kegedy/Arduino-Uno-Rev3-Remodeled/Project Outputs for 28Pins_Project/BOM/BOM Grouped Reference - 28Pins V1I1 - FIXED 5V and 3V3.xlsx

Designator | Quantity | Comment | Description | Case/Package | Manufacturer | Manufacturer Part Number | Supplier 1 | Supplier Part Number 1
C1, C2, C5, C12, C25, C26, C28, C29 | 8 | 10uF / 16V | CERAMIC CAPACITOR, 10UF, 16V, X5R, 20%, 0805, FULL REEL; Product Range:C Series; Capacitance:10 F; Capacitance Tolerance: 20%; Dielectric Characteristic:X5R; Voltage Rating:16V; Ceramic Capacitor Case:0805 [2012 Metric]; MSL:- ;RoHS Compliant: Yes | 0805 | TDK | C2012X5R1C106M125AC | Farnell | 2525134
C3, C4, C6, C7, C8, C9, C10, C11, C13, C14, C15, C18, C20, C21, C24, C27, C30, C31 | 18 | 100nF | C Series 0805 0.1 uF 50 V ±10 % Tolerance X7R SMT Multilayer Ceramic Capacitor | 0805 | TDK | C2012X7R1H104K085AA | Digi-Key | 445-7534-1-ND
C16, C17 | 2 | 100uF / 10V | CAP ALUM 100UF 20% 10V SMD | Radial | Panasonic | EEE-1AA101WR | Digi-Key | PCE3867DKR-ND
C19 | 1 | 1uF / 25V | CAP CER 1UF 25V X5R 0805 | 0805 | TDK | C2012X5R1E105K125AA | Digi-Key | 445-1419-1-ND
C22, C23, C32, C33 | 4 | 18pf | Cap Ceramic 18pF 50V C0G 5% SMD 0805 125C Paper T/R | 0805 | KEMET | C0805C180J5GACTU | Digi-Key | 399-C0805C180J5GAC7800CT-ND
D1, D3 | 2 | BAT54HT1G | VR=30V IF=200mA 10pF P=200mW |  | ON Semiconductor / Fairchild | BAT54HT1G | Digi-Key | BAT54HT1GOSCT-ND
D2 | 1 | Green | LED Uni-Color True Green 525nm 2-Pin Chip 0603(1608Metric) T/R | 0603 | Osram Opto | LT Q39G-Q1OO-25-1 | Mouser | 720-LTQ39GQ1S22515
D4, D5, D6 | 3 | Orange | LED Uni-Color Orange 610nm 2-Pin Case 0603 T/R | 1608 | Osram Opto | LOL29K-H2K1-24 | Mouser | 720-LOL29KH2K124Z
FB1, FB2, FB3 | 3 | MPZ2012S601AT000 | 0805 600Ω ±25% DCR=0.1Ω 2A | 0805 | TDK | MPZ2012S601AT000 | Digi-Key | 445-MPZ2012S601AT000CT-ND
J1, J3 | 2 | HEADER FEMALE 1x8 2.54mm | 2.54mm (0.1") Pitch SIL Vertical PC Tail Socket Assembly, selective gold + tin, 8 contacts | SIL | Harwin | M20-7820842 | Digi-Key | 952-1823-ND
J2 | 1 | HEADER FEMALE 1x6 2.54mm | 2.54mm (0.1") Pitch SIL Vertical PC Tail Socket Assembly, tin, 6 contacts | SIL | Harwin | M20-7820646 | Digi-Key | 952-1809-ND
J4 | 1 | HEADER FEMALE 1x10 2.54mm | 2.54mm (0.1") Pitch SIL Vertical PC Tail Socket Assembly, tin, 10 contacts | SIL | Harwin | M20-7821046 | Digi-Key | 952-1847-ND
J5, J6 | 2 | HDR 2x3 | Conn Unshrouded Header HDR 6 POS 2.54mm Solder ST Top Entry Thru-Hole BergStik® Bulk |  | Amphenol ICC / FCI | 67997-106HLF | Mouser | 649-67997-106HLF
J7 | 1 | 10118193-0001LF | FCI Right Angle Surface Mount Mount Female USB Connector; 100 V ac; 1.8A |  | Amphenol ICC / FCI | 10118193-0001LF | Mouser | 649-10118193-0001LF
JP1, JP4 | 2 | HDR 1x3 | Conn Unshrouded Header HDR 3 POS 2.54mm Solder ST Top Entry Thru-Hole BergStik® Automotive Bulk |  | Amphenol ICC / FCI | 68000-103HLF | Mouser | 649-68000-103HLF
JP3 | 1 | HDR 1x4 | Conn Unshrouded Header HDR 4 POS 2.54mm Solder ST Thru-Hole Bag |  | Amphenol ICC / FCI | 68001-204HLF | Mouser | 649-68001-204HLF
L1 | 1 | 2u2 / 2A | Inductor RF Chip Wirewound 2.2uH 20% 100KHz 1.13A 0.104Ohm DCR 1210 T/R | 1210 | KEMET | L1210R2R2MDWIT | Digi-Key | 399-9598-1-ND
LINK1, LINK2, LINK3 | 3 | LINK | 2 Position 2.54 mm Centerline Single Circuit Open Top Jumper | 100 | Sullins | QPC02SXGN-RC | Digi-Key | S9337-ND
R2, R3, R15 | 3 | 10K | Res Thick Film 0805 10K Ohm 1% 0.125W(1/8W) +/-100ppm/C Epoxy Pad SMD T/R | 0805 | Yageo | RC0805FR-0710KL | Digi-Key | 311-10.0KCRCT-ND
R4, R5, R7, R9, R13, R14, R17, R19, R20, R26 | 10 | 22R | Res Thick Film 0805 22 Ohm 1% 0.125W(1/8W) ±100ppm/C Pad SMD T/R | 0805 | Yageo | RC0805FR-0722RL | Digi-Key | 311-22.0CRCT-ND
R6, R8, R11, R12, R18 | 5 | 560R | Res General Purpose Thick Film 0805 560 Ohm 1% 1/8W ±100ppm/°C Molded Paper T/R | 0805 | Yageo | RC0805FR-07560RL | Digi-Key | 311-560CRCT-ND
R10 | 1 | 100K | Res Thick Film 0805 100K Ohm 1% 1/8W ±100ppm/°C Molded SMD Paper T/R | 0805 | Yageo | RC0805FR-07100KL | Digi-Key | 311-100KCRCT-ND
R16, R22 | 2 | 1M | Res Thick Film 0805 1M Ohm 1% 0.125W(1/8W) ±100ppm/C Pad SMD T/R | Molded | Yageo | RC0805FR-071ML | Digi-Key | 311-1.00MCRDKR-ND
R21 | 1 | 0R | Surface Mount Thick Film Resistor, RC Series, 125 mW, - 5%, 150 V, 0805 [2012 Metric] | 0805 | Yageo | RC0805JR-070RL | Digi-Key | 311-0.0ARCT-ND
R23, R24, R25 | 3 | 1K | RES SMD 1K OHM 1% 1/8W 0805 | 0805 | Yageo | RC0805FR-071KL | Digi-Key | 311-1.00KCRCT-ND
SCKT1 | 1 | 28-DIP Socket | Socket DIP 28Cnts DualWipe 0.3InSpc. PhosphorBronze Nickel KinkedTail 4800Series |  | 3M | 4828-3004-CP | Digi-Key | 3M5480-ND
SW1, SW2 | 2 | 1825910-6 | Switch Tactile OFF (ON) SPST Round Button PC Pins 0.05A 24VDC 1.57N Thru-Hole Loose |  | TE Connectivity Alcoswitch | 1825910-6 | Digi-Key | 450-1650-ND
U1 | 1 | ATMEGA328P-PU | ATMEGA328P-PU; 8 bit Microcontroller AVR 20MHz 1; 32kb Flash; 2kb RAM; I2C SPI 2 | PDIP | Microchip / Atmel | ATMEGA328P-PU | Digi-Key | ATMEGA328P-PU-ND
U2 | 1 | ATMEGA16U2-AU | 8-bit AVR MCU, 16 KB, 512 Bytes, 16 MHz, 2.7 to 5.5V, TQFP-32, RoHS | TQFP | Microchip | ATMEGA16U2-AU | Digi-Key | ATMEGA16U2-AU-ND
U3 | 1 | TL1963A-33DCQR | LDO Regulator Pos 3.3V 1.5A 6-Pin(5+Tab) SOT-223 T/R | SOT-223 | Texas Instruments | TL1963A-33DCQR | Digi-Key | 296-24534-6-ND
U4, U5, U6, U7 | 4 | SN74AHC1G09DCKR | SN74AHC1G09 Single 2-INPUT Posit | SC | Texas Instruments | SN74AHC1G09DCKR | Digi-Key | 296-29203-1-ND
Y1 | 1 | ABM7-10.000MHZ-D2Y-T | Crystal 10MHz ±20ppm (Tol) ±30ppm (Stability) 18pF FUND 80Ohm 2-Pin Mini-CSMD T/R | SMD/SMT | Abracon | ABM7-10.000MHZ-D2Y-T | Digi-Key | 535-9833-1-ND
Y2 | 1 | ABM7-8.000MHZ-D2Y-T | Crystal 8MHz ±20ppm (Tol) ±30ppm (Stability) 18pF FUND 100Ohm 2-Pin Mini-CSMD T/R | CSMD | Abracon | ABM7-8.000MHZ-D2Y-T | Digi-Key | 535-9831-1-ND
Z1, Z2 | 2 | CG0603MLC-05E | ESD Suppressor Multilayer Varistor 5V Automotive 2-Pin Case 0603(1608Metric) T/R | 0603 | Bourns | CG0603MLC-05E | Digi-Key | CG0603MLC-05ECT-ND
