kegedy/Arduino-Uno-Rev3-Remodeled/Released Files/Step 5 - Schematic/Schematic - 28Pins V1I1 - FIXED 5V.PDF

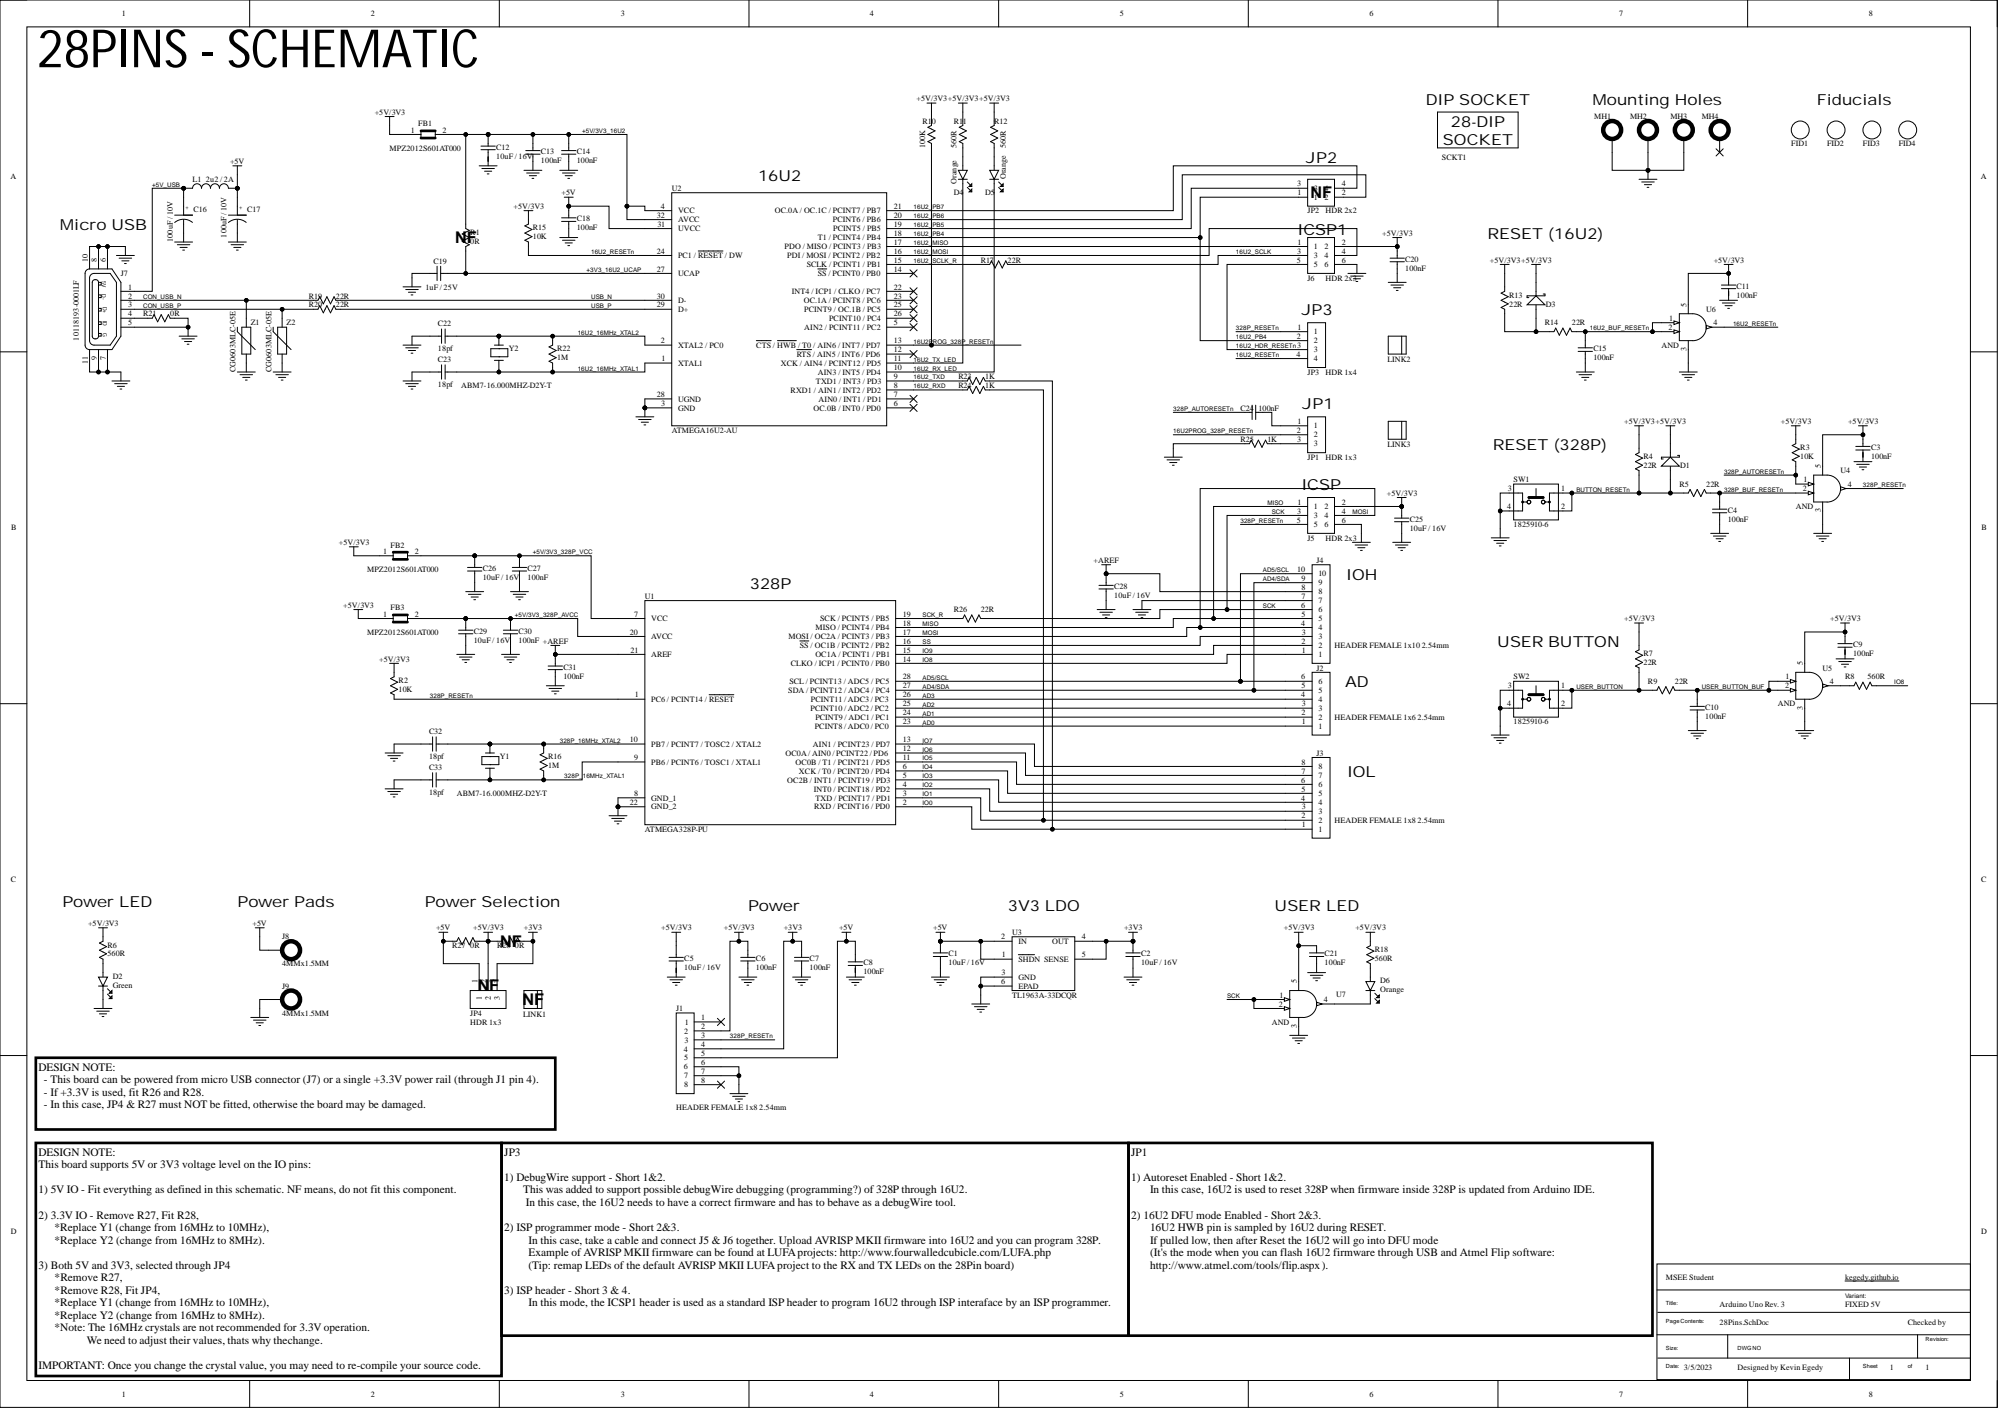
[picture p1: page 1]

UVCC 31 AVCC 32 | 16U2_PB6
PC1 / RESET / DW 24 | 16U2_PB4 | ICSP1

16U2_MISO

16U2PROG_328P_RESETn 16U2_TX_LED | | 328P_RESETn 16U2_PB4

16U2_HDR_RESETn | | 3 3

IO5
IO3 | | | 1 1 2 2 3 3 4 4 5 5 6 6 7 7 8 8
IO4

328P_16MHz_XTAL1 | GND_1 8

IO2
IO1

GND_2 22 | IO0

DESIGN NOTE:
- This board can be powered from micro USB connector (J7) or a single +3.3V power rail (through J1 pin 4).
- If +3.3V is used, fit R26 and R28.
- In this case, JP4 & R27 must NOT be fitted, otherwise the board may be damaged.

This board supports 5V or 3V3 voltage level on the IO pins:

1) DebugWire support - Short 1&2.
This was added to support possible debugWire debugging (programming?) of 328P through 16U2.
In this case, the 16U2 needs to have a correct firmware and has to behave as a debugWire tool.

1) Autoreset Enabled - Short 1&2.
In this case, 16U2 is used to reset 328P when firmware inside 328P is updated from Arduino IDE.

1) 5V IO - Fit everything as defined in this schematic. NF means, do not fit this component.

2) 3.3V IO - Remove R27, Fit R28,
*Replace Y1 (change from 16MHz to 10MHz),
*Replace Y2 (change from 16MHz to 8MHz).

2) 16U2 DFU mode Enabled - Short 2&3.
16U2 HWB pin is sampled by 16U2 during RESET.
If pulled low, then after Reset the 16U2 will go into DFU mode
(It's the mode when you can flash 16U2 firmware through USB and Atmel Flip software:
http://www.atmel.com/tools/flip.aspx ).

2) ISP programmer mode - Short 2&3.
In this case, take a cable and connect J5 & J6 together. Upload AVRISP MKII firmware into 16U2 and you can program 328P.
Example of AVRISP MKII firmware can be found at LUFA projects: http://www.fourwalledcubicle.com/LUFA.php
(Tip: remap LEDs of the default AVRISP MKII LUFA project to the RX and TX LEDs on the 28Pin board)

3) Both 5V and 3V3, selected through JP4
*Remove R27,
*Remove R28, Fit JP4,
*Note: The 16MHz crystals are not recommended for 3.3V operation.

3) ISP header - Short 3 & 4.
In this mode, the ICSP1 header is used as a standard ISP header to program 16U2 through ISP interaface by an ISP programmer.

We need to adjust their values, thats why thechange.

Size: | DWG NO | Revision:

IMPORTANT: Once you change the crystal value, you may need to re-compile your source code.

Date: 3/5/2023 Designed by Kevin Egedy | Sheet 1 of 1
