kegedy/Arduino-Uno-Rev3-Remodeled/Project Outputs for 28Pins_Project/28Pins Mechanical Drawing.PDF

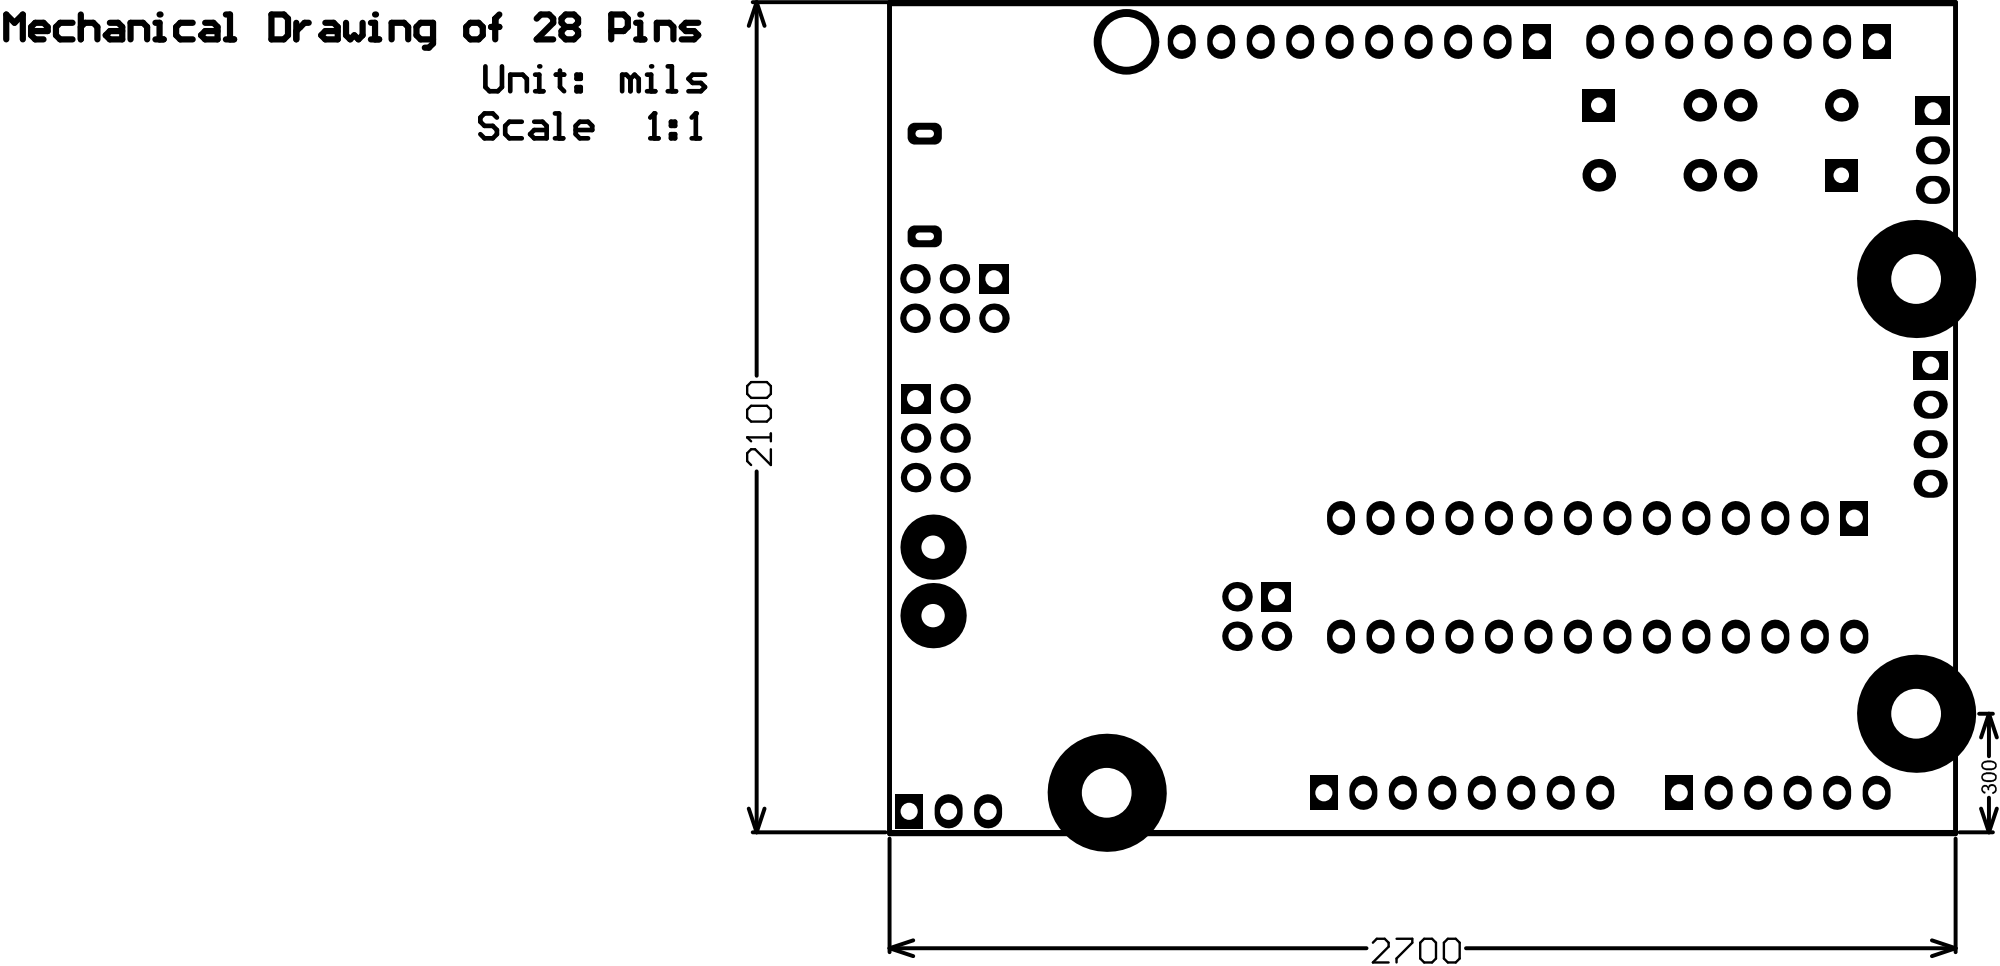
[picture p2: page 1]
