kegedy/Arduino-Uno-Rev3-Remodeled/Project Outputs for 28Pins_Project/Assembly Drawing - 28Pins V1I1 - FIXED 5V and 3V3.PDF

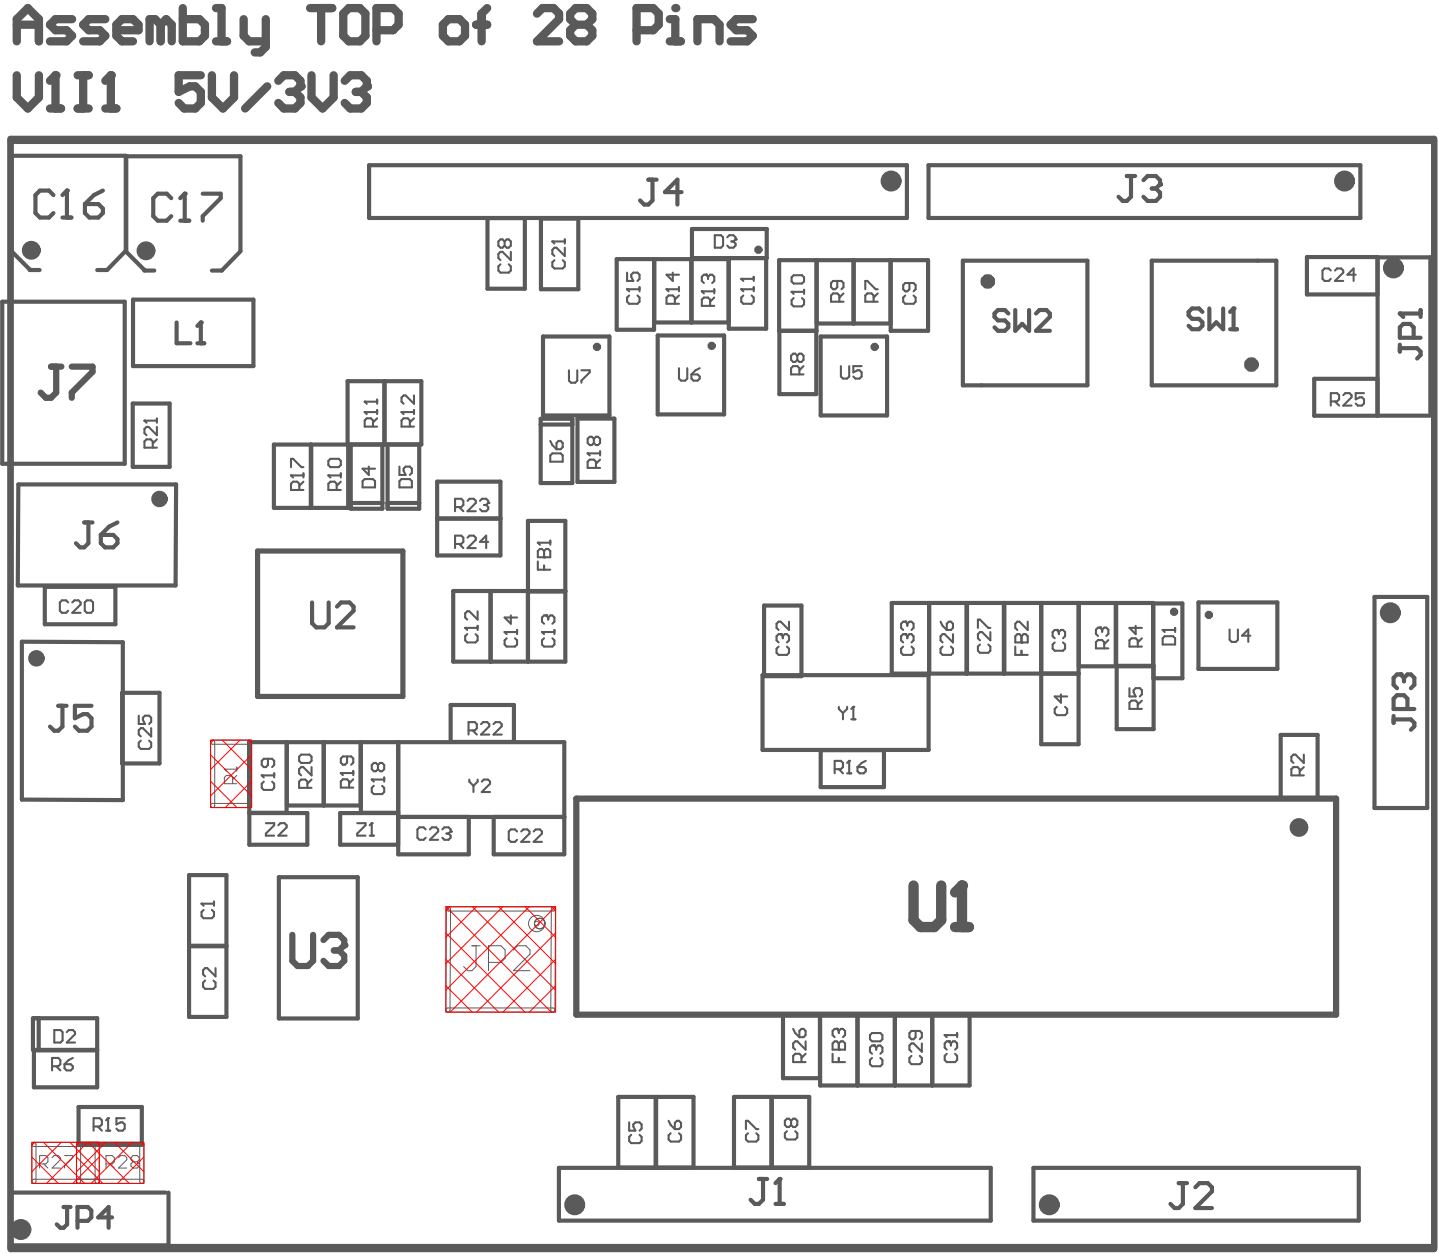
[picture p3: page 1]
