kegedy/Arduino-Uno-Rev3-Remodeled/Project Outputs for 28Pins_Project/Assembly Drawing - 28Pins V1I1 - FIXED 5V.PDF

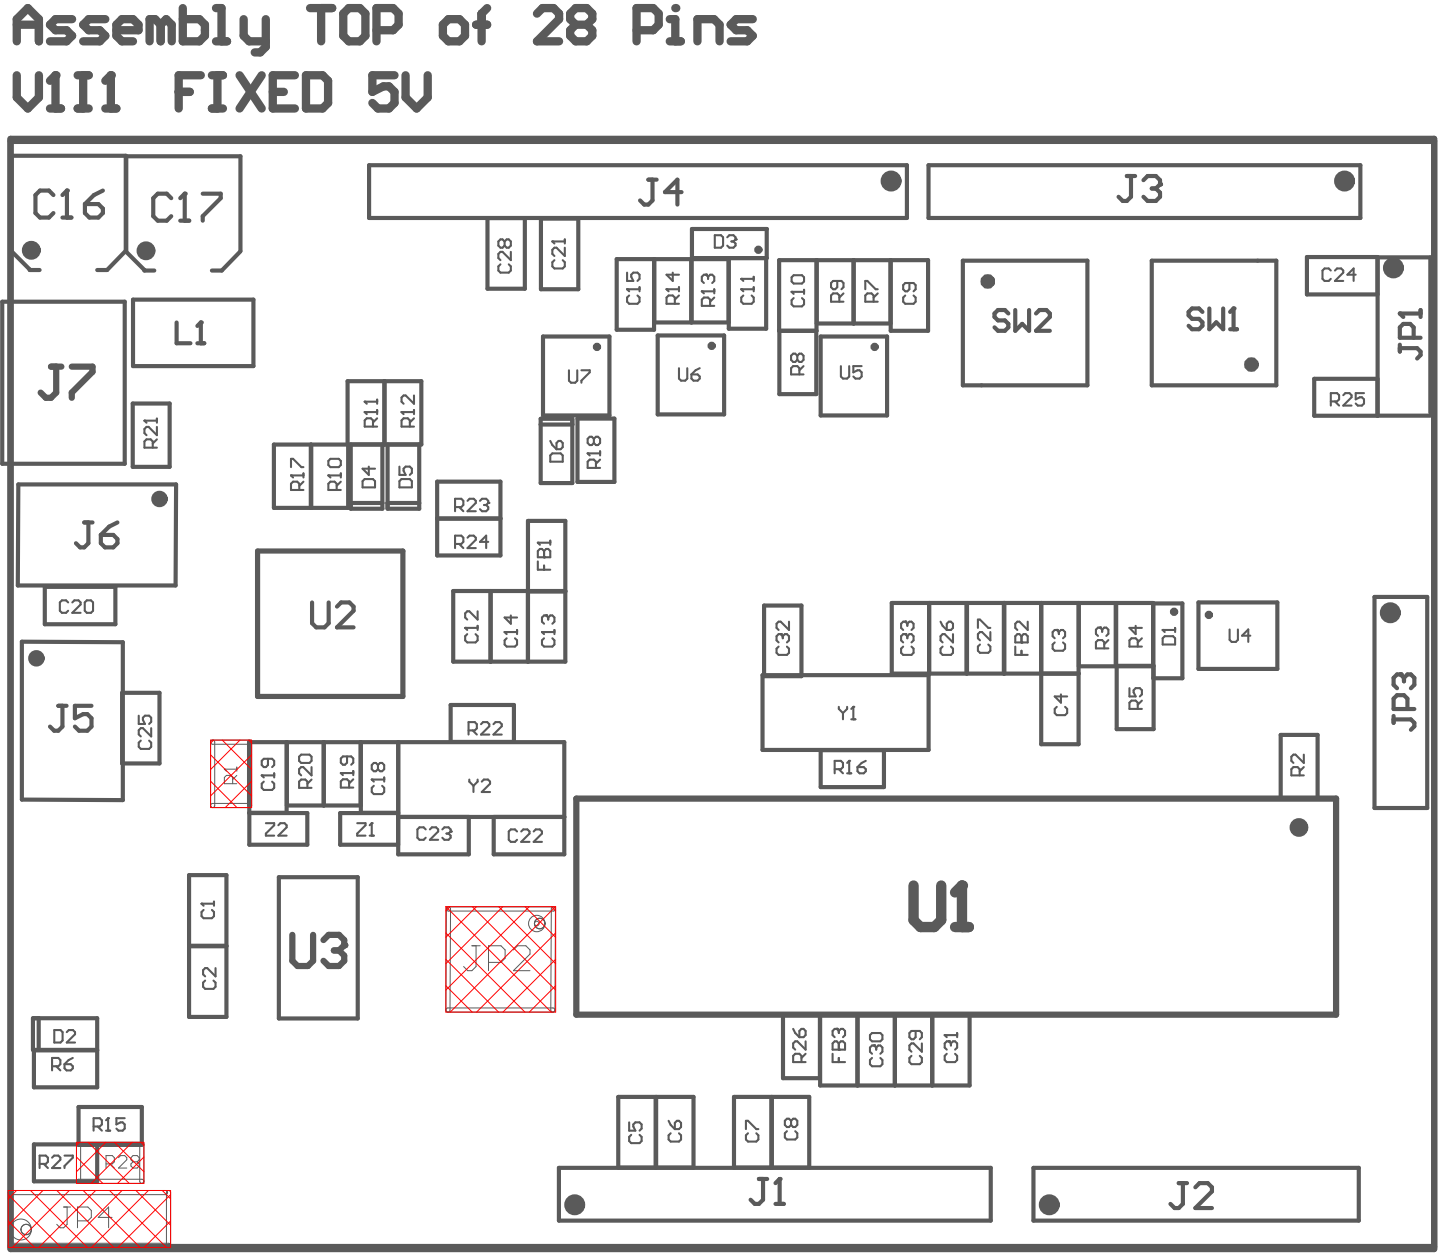
[picture p4: page 1]
