kegedy/Arduino-Uno-Rev3-Remodeled/Released Files/Step 1 - PCB Manufacturing/NC Drill Output/28Pins Drill Drawings.PDF

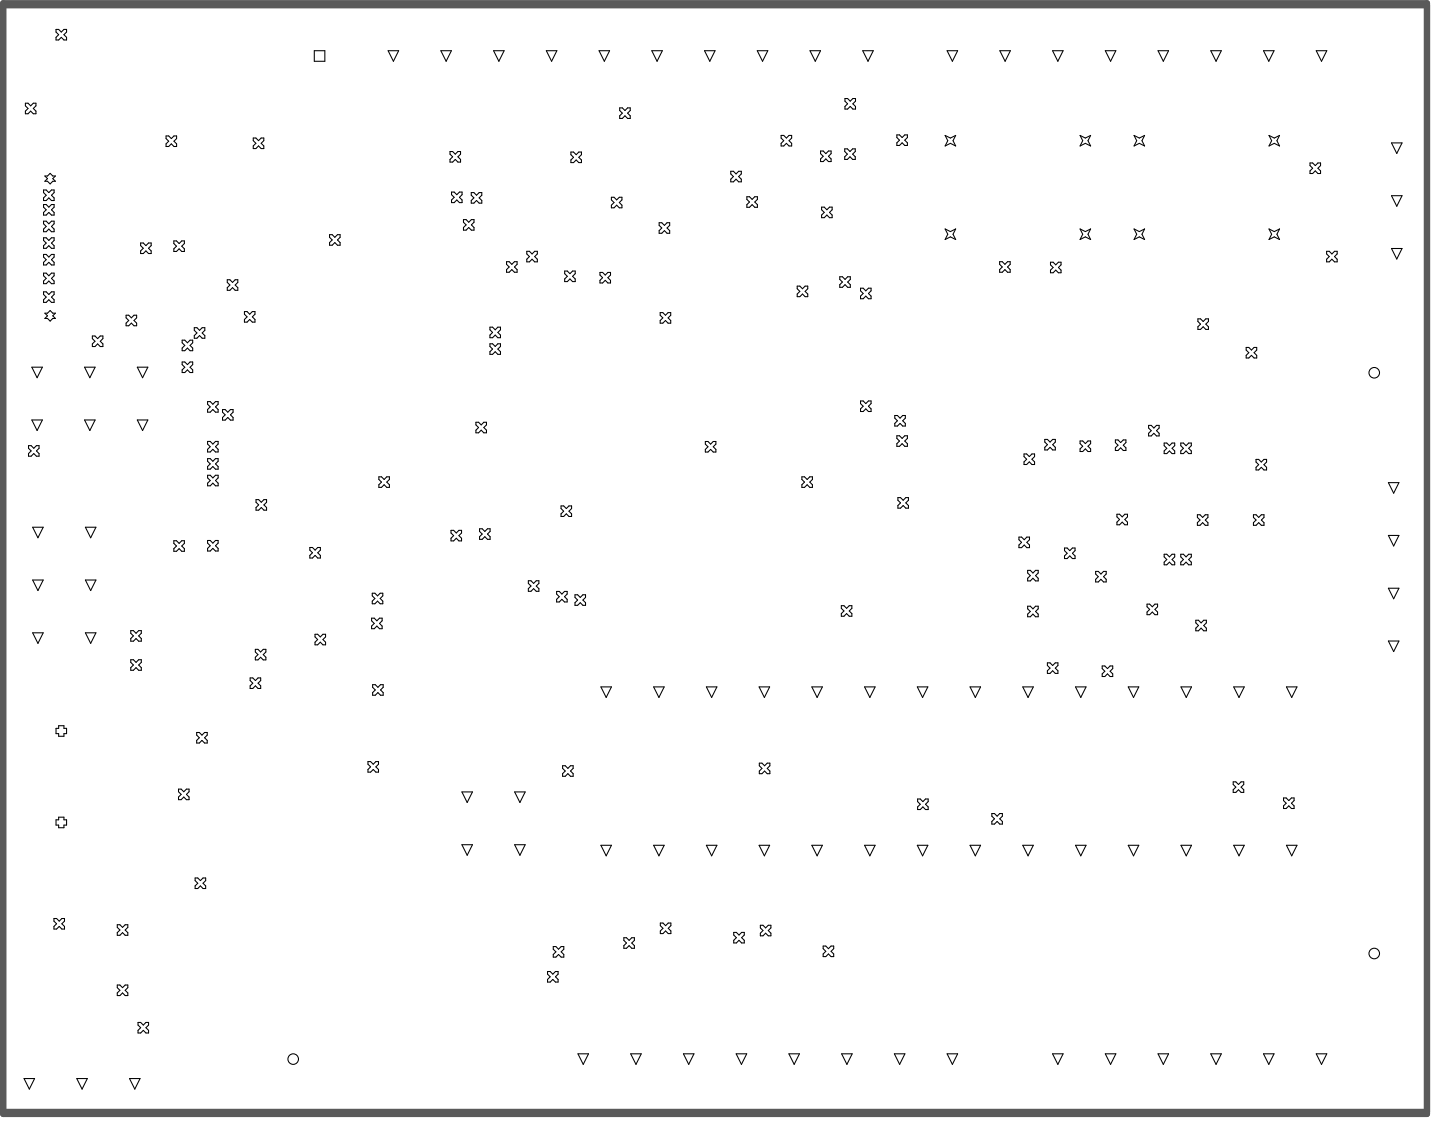
[picture p5: page 1]
