kegedy/Arduino-Uno-Rev3-Remodeled/Released Files/Step 2 - Board Assembly/Variant 1 - 28Pins V1I1 - FIXED 5V/Top View Drawing - 28Pins V1I1 - FIXED 5V.PDF

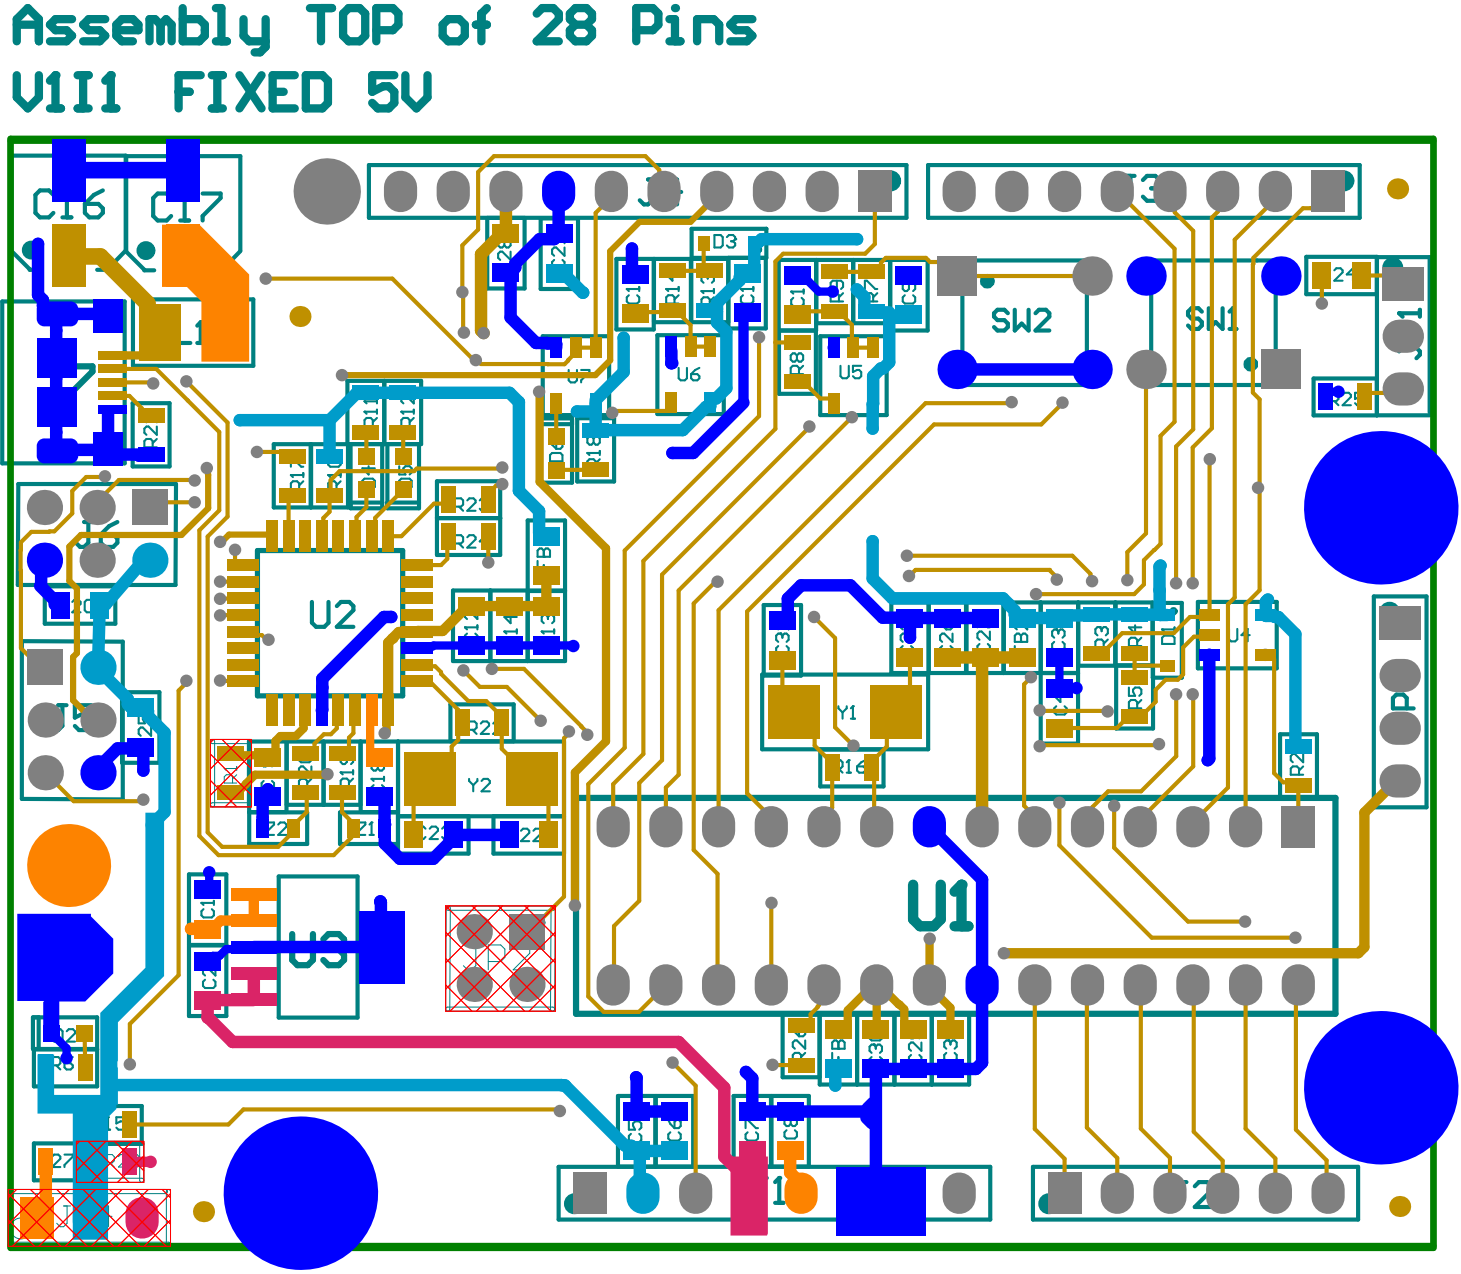
[picture p6: page 1]
