kegedy/Arduino-Uno-Rev3-Remodeled/Released Files/Step 2 - Board Assembly/Variant 2 - 28Pins V1I1 - FIXED 5V_3V3/Top View Drawing - 28Pins V1I1 - FIXED 5V_3V3.PDF

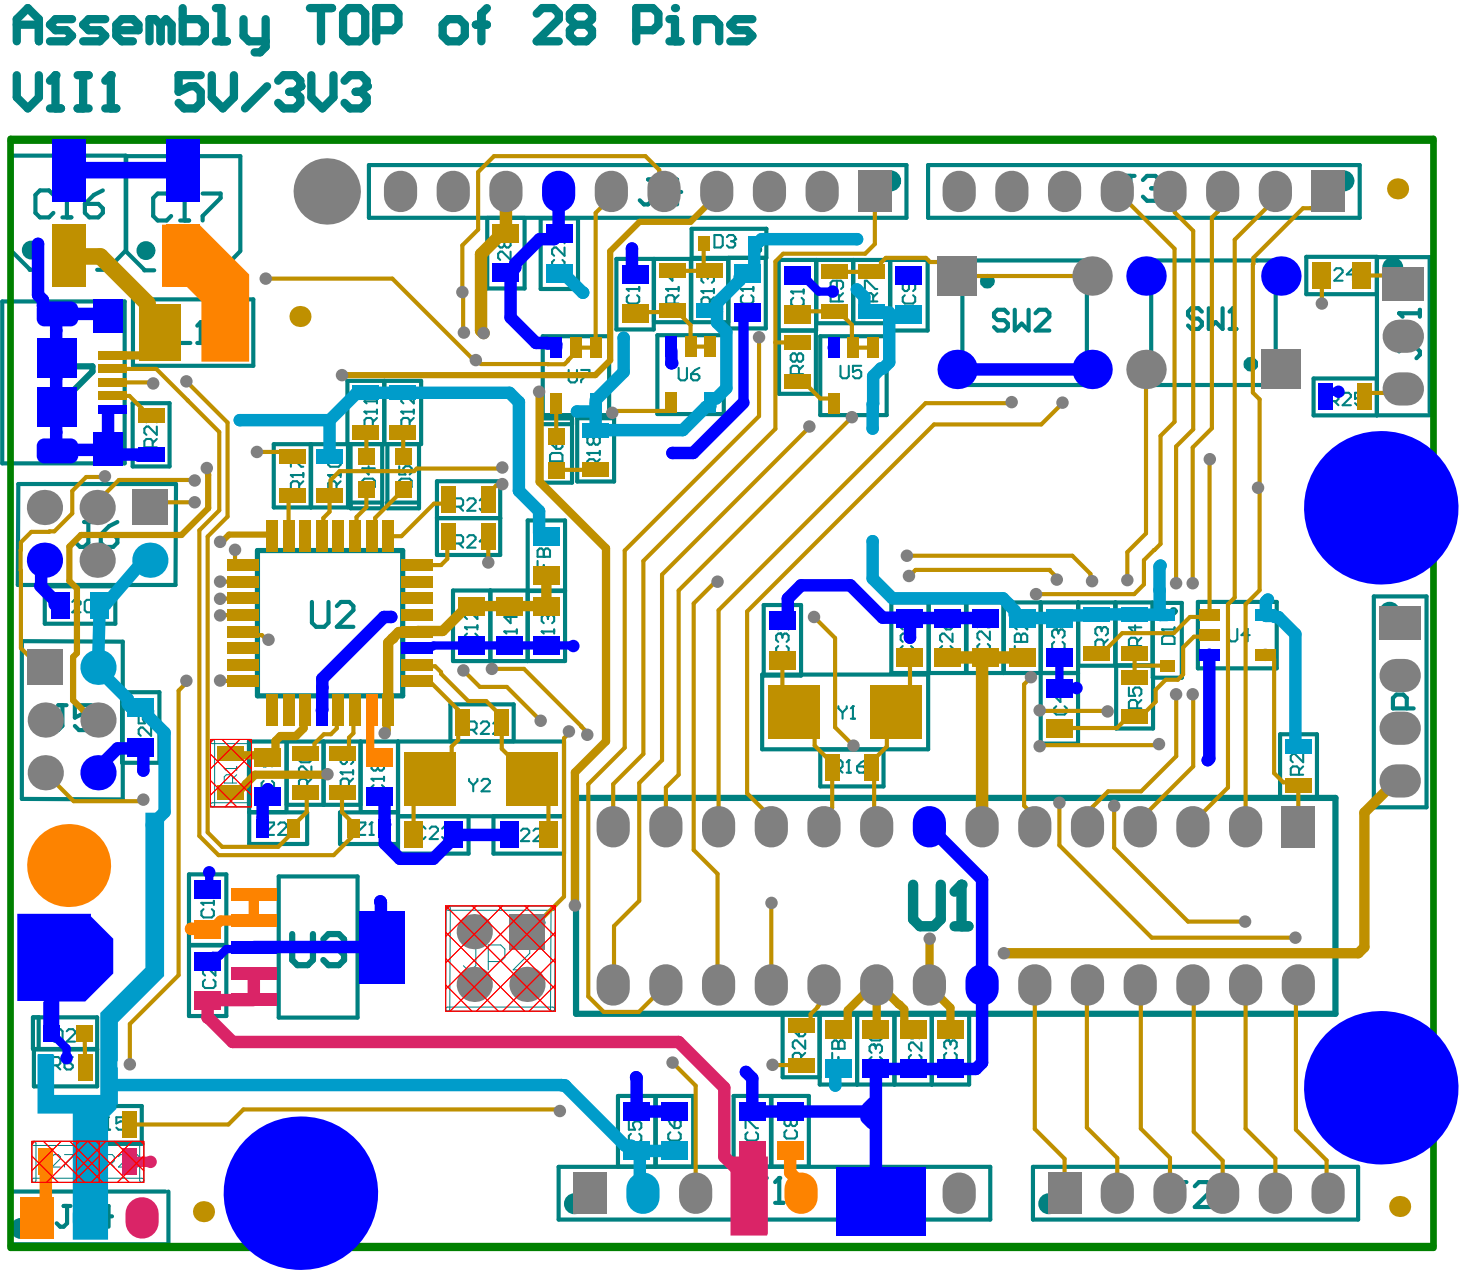
[picture p7: page 1]
