kegedy/Arduino-Uno-Rev3-Remodeled/(list of files, drawings)

Other design files:
28Pins.PcbLib
28Pins.SchDoc
28Pins.SchLib
28Pins_Project.PrjPcb
